CircuitMonkey/6530-CHIPz-reDIP-RIOT/hardware/documentation/ice_to_signal_map.ods

CHP Name | Pin Num | ICE Num
Vss | 1
PA0 | 2 | ICE32
Phi 2 | 3 | ICE31
RSO | 4 | ICE28
A9 | 5 | ICE39_OD
A8 | 6 | ICE40_OD
A7 | 7 | ICE41_OD
A6 | 8 | ICE25
RW | 9 | ICE26
A5 | 10 | ICE27
A4 | 11 | ICE23
A3 | 12 | ICE21
A2 | 13 | ICE20
A1 | 14 | SPI_SIO3
A0 | 15 | SPI_SIO2
RST | 16 | SPI_SIO1
IRQ/PB7 | 17 | SPI_SCLK
CS1/PB6 | 18 | SPI_SIO0
CS2/PB5 | 19 | ICE13
Vcc | 20
PB4 | 21 | ICE12
PB3 | 22 | ICE11
PB2 | 23 | ICE10
PB1 | 24 | ICE9
PB0 | 25 | ICE47
D7 | 26 | ICE48
D6 | 27 | ICE2
D5 | 28 | ICE3
D4 | 29 | ICE4
D3 | 30 | ICE6
D2 | 31 | ICE46
D1 | 32 | ICE45
D0 | 33 | ICE44
PA7 | 34 | ICE43
PA6 | 35 | ICE42
PA5 | 36 | ICE38
PA4 | 37 | ICE37
PA3 | 38 | ICE36
PA2 | 39 | ICE35
PA1 | 40 | ICE34
