CircuitMonkey/6530-CHIPz-reDIP-RIOT/hardware/documentation/CHIPz-RIOT-bom.ods

CHIPz 6530 RIOT Module for KIM-1000 |  |  | Rev. A
Reference | Qty | Value | Footprint | Datasheet
C1,C3,C11 | 3 | 4.7uF | Capacitor_SMD:C_0402_1005Metric_Pad0.74x0.62mm_HandSolder | ~
C2,C4,C5,C6,C7,C8,C9,C10 | 8 | 0.1uF | Capacitor_SMD:C_0402_1005Metric_Pad0.74x0.62mm_HandSolder | ~
J1 | 1 | Conn_01x10 | Connector_JST:JST_SHL_SM10B-SHLS-TF_1x10-1MP_P1.00mm_Horizontal | ~
Q1 | 1 | BC847W | Package_TO_SOT_SMD:SOT-323_SC-70 | http://www.infineon.com/dgdl/Infineon-BC847SERIES_BC848SERIES_BC849SERIES_BC850SERIES-DS-v01_01-en.pdf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
Q2 | 1 | FDN340P | Package_TO_SOT_SMD:SOT-23 | https://www.onsemi.com/pub/Collateral/FDN340P-D.PDF
R1 | 1 | 100 | Resistor_SMD:R_0402_1005Metric_Pad0.72x0.64mm_HandSolder | ~
R2,R4 | 2 | 10K | Resistor_SMD:R_0402_1005Metric_Pad0.72x0.64mm_HandSolder | ~
R3 | 1 | 2.87K | Resistor_SMD:R_0402_1005Metric_Pad0.72x0.64mm_HandSolder | ~
R5 | 1 | 1K | Resistor_SMD:R_0402_1005Metric_Pad0.72x0.64mm_HandSolder | ~
R6 | 1 | 20K | Resistor_SMD:R_0402_1005Metric_Pad0.72x0.64mm_HandSolder | ~
R7 | 1 | 100K | Resistor_SMD:R_0402_1005Metric_Pad0.72x0.64mm_HandSolder | ~
U1 | 1 | NCP115AMX120TCG | onsemi:CASE_711AJ_1.0x1.0mm_P0.65mm | https://www.onsemi.com/pdf/datasheet/ncp115-d.pdf
U2 | 1 | ICE40UP5K-SG48ITR | Package_DFN_QFN:QFN-48-1EP_7x7mm_P0.5mm_EP5.6x5.6mm | http://www.latticesemi.com/Products/FPGAandCPLD/iCE40Ultra
U3 | 1 | AT25SF081BMAH*T | CM_Chip_Packages:UDFN-8_EP_3x2_Pitch0.5mm | https://www.adestotech.com/wp-content/uploads/DS-AT25SF081_045.pdf
