CircuitMonkey/6530-CHIPz-reDIP-RIOT/hardware/documentation/CHIPz-RIOT-sch.pdf

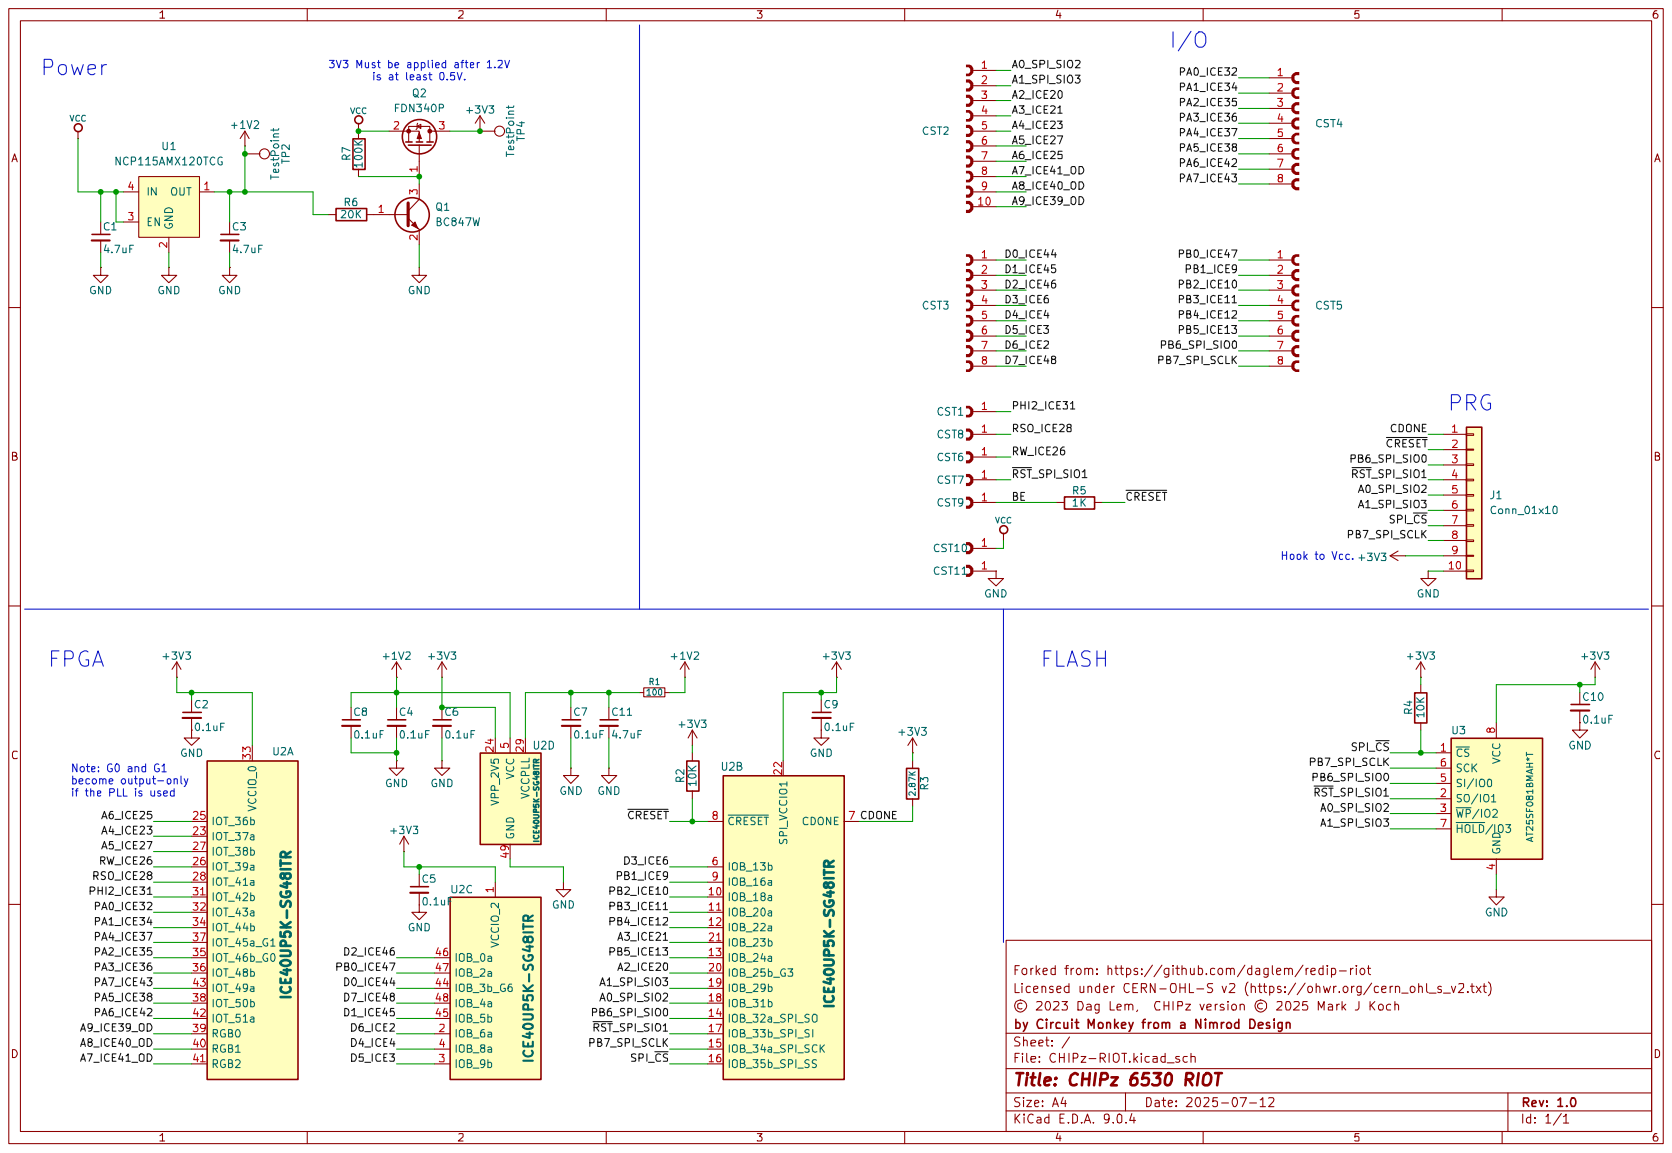
[picture p1: page 1]
