CircuitMonkey/6530-CHIPz-reDIP-RIOT/hardware/CHIPz-RIOT.kicad_pcb

## KiCad design hardware/CHIPz-RIOT.kicad_pcb (2025-07-17)

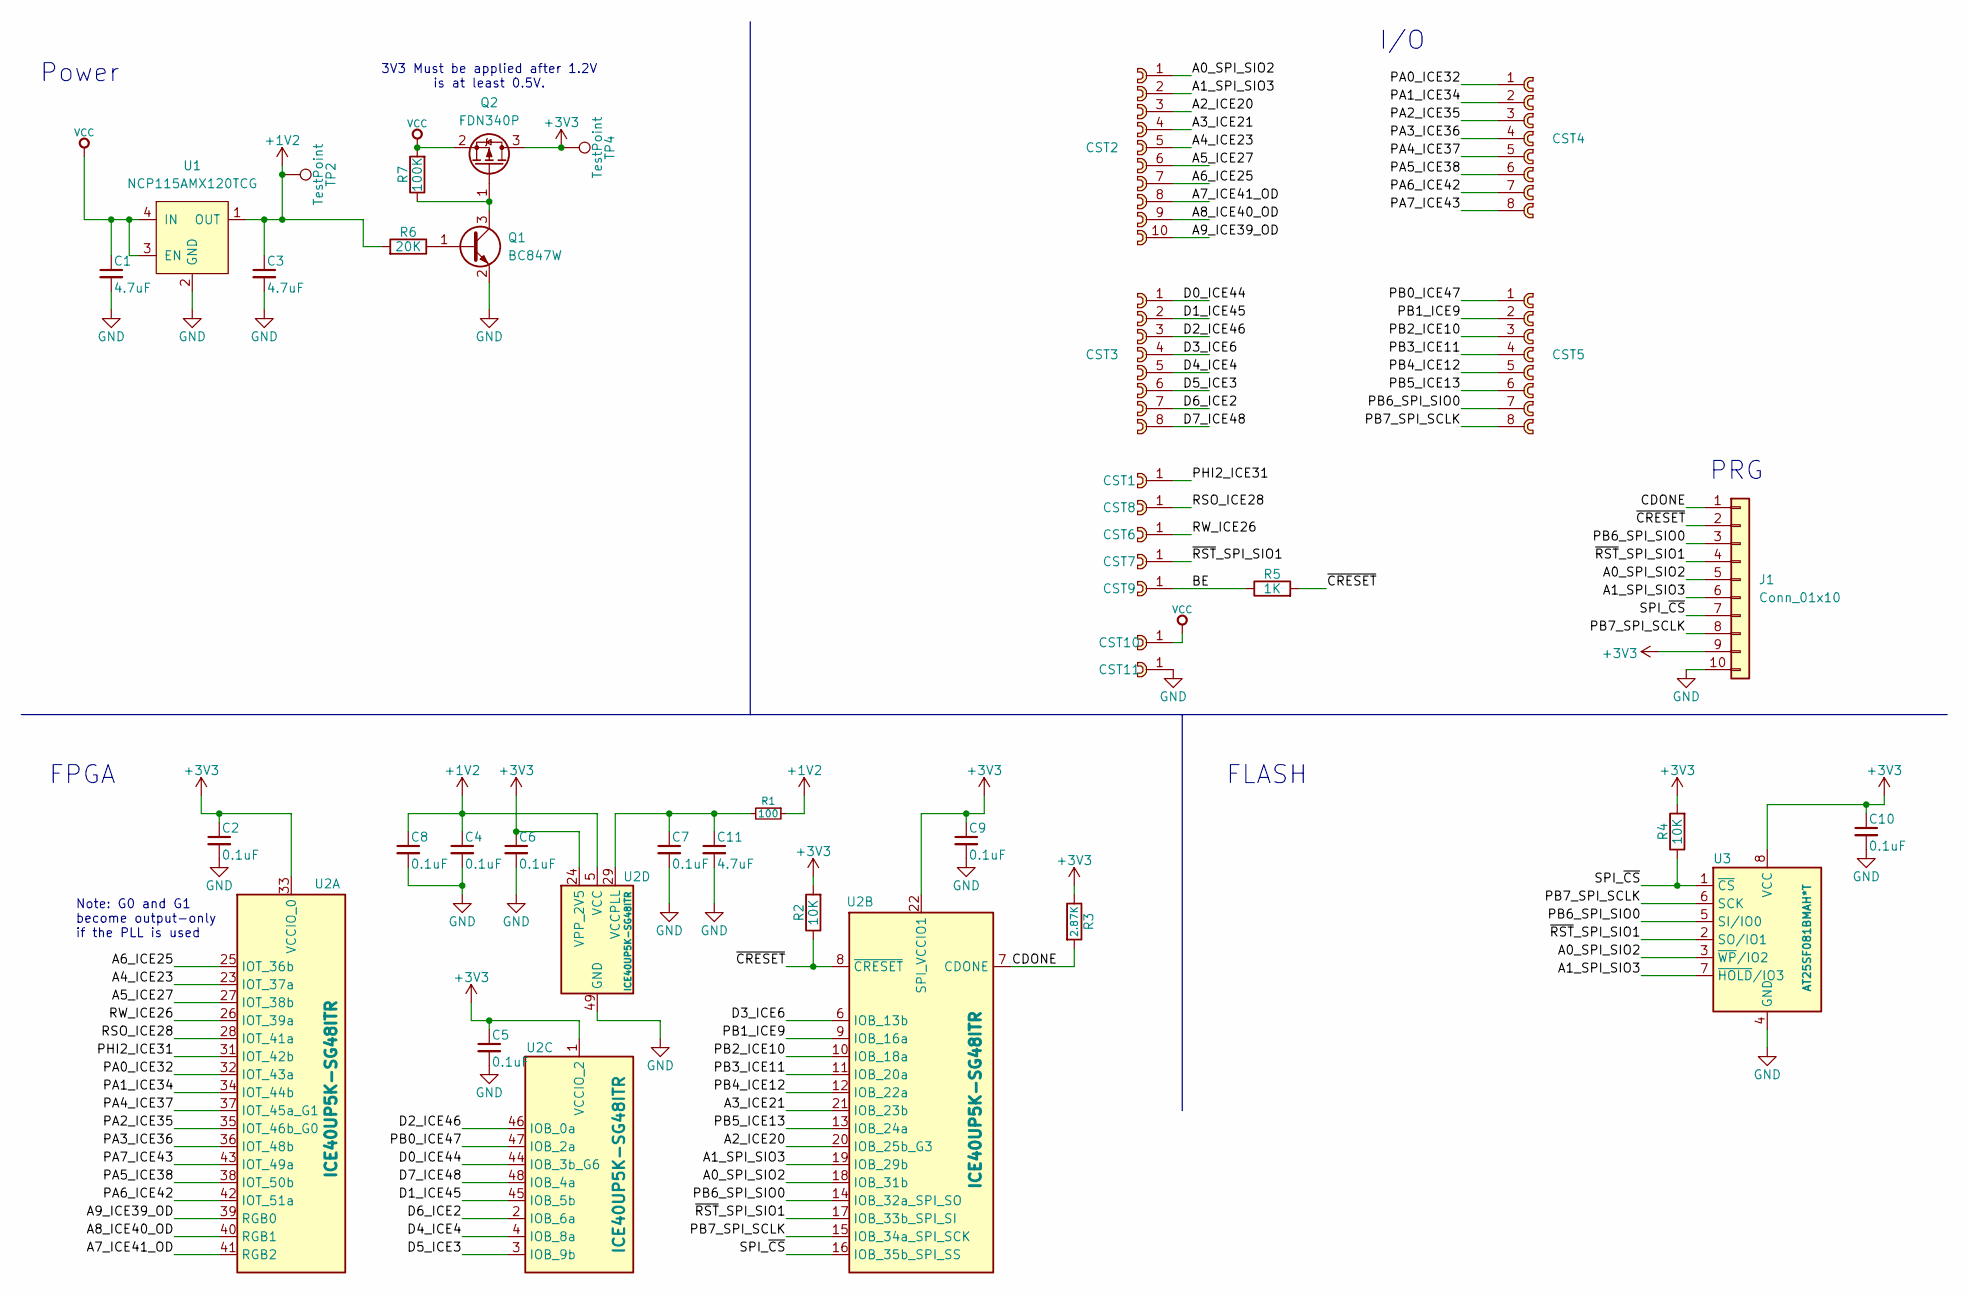
[picture p2: schematic CHIPz-RIOT.kicad_sch, CHIPz 6530 RIOT]

Parts:
C1, C3, C11: 4.7uF; C_0402_1005Metric_Pad0.74x0.62mm_HandSolder
C2, C4, C5, C6, C7, C8, C9, C10: 0.1uF; C_0402_1005Metric_Pad0.74x0.62mm_HandSolder
CST1, CST6, CST7, CST8, CST9, CST10, CST11: cast-2.0-01P
CST2: cast-2.0-10P
CST3, CST4, CST5: cast-2.0-08P
J1: Conn_01x10; JST_SHL_SM10B-SHLS-TF_1x10-1MP_P1.00mm_Horizontal
Q1: BC847W; SOT-323_SC-70
Q2: FDN340P; SOT-23
R1: 100; R_0402_1005Metric_Pad0.72x0.64mm_HandSolder
R2, R4: 10K; R_0402_1005Metric_Pad0.72x0.64mm_HandSolder
R3: 2.87K; R_0402_1005Metric_Pad0.72x0.64mm_HandSolder
R5: 1K; R_0402_1005Metric_Pad0.72x0.64mm_HandSolder
R6: 20K; R_0402_1005Metric_Pad0.72x0.64mm_HandSolder
R7: 100K; R_0402_1005Metric_Pad0.72x0.64mm_HandSolder
TP2, TP4: TestPoint; TestPoint_Pad_D1.00mm
U1: NCP115AMX120TCG; CASE_711AJ_1.0x1.0mm_P0.65mm
U2: ICE40UP5K-SG48ITR; QFN-48-1EP_7x7mm_P0.5mm_EP5.6x5.6mm
U3: AT25SF081BMAH*T; UDFN-8_EP_3x2_Pitch0.5mm

Connections:
+1V2: C3.1, C4.1, C8.1, R1.1, R6.2, TP2.1, U1.1 (OUT), U2.5 (VCC), U2.30 (VCC)
+3V3: C2.1, C5.1, C6.1, C9.1, C10.1, J1.9, Q2.3 (D), R2.2, R3.1, R4.2, TP4.1, U2.1 (VCCIO_2), U2.22 (SPI_VCCIO1), U2.24 (VPP_2V5), U2.33 (VCCIO_0), U3.8 (VCC)
/A0_SPI_SIO2: CST2.1, J1.5, U2.18 (IOB_31b), U3.3 (~WP/IO2)
/A1_SPI_SIO3: CST2.2, J1.6, U2.19 (IOB_29b), U3.7 (~HOLD/IO3)
/A2_ICE20: CST2.3, U2.20 (IOB_25b_G3)
/A3_ICE21: CST2.4, U2.21 (IOB_23b)
/A4_ICE23: CST2.5, U2.23 (IOT_37a)
/A5_ICE27: CST2.6, U2.27 (IOT_38b)
/A6_ICE25: CST2.7, U2.25 (IOT_36b)
/A7_ICE41_OD: CST2.8, U2.41 (RGB2)
/A8_ICE40_OD: CST2.9, U2.40 (RGB1)
/A9_ICE39_OD: CST2.10, U2.39 (RGB0)
/BE: CST9.1, R5.1
/CDONE: J1.1, R3.2, U2.7 (CDONE)
/D0_ICE44: CST3.1, U2.44 (IOB_3b_G6)
/D1_ICE45: CST3.2, U2.45 (IOB_5b)
/D2_ICE46: CST3.3, U2.46 (IOB_0a)
/D3_ICE6: CST3.4, U2.6 (IOB_13b)
/D4_ICE4: CST3.5, U2.4 (IOB_8a)
/D5_ICE3: CST3.6, U2.3 (IOB_9b)
/D6_ICE2: CST3.7, U2.2 (IOB_6a)
/D7_ICE48: CST3.8, U2.48 (IOB_4a)
/PA0_ICE32: CST4.1, U2.32 (IOT_43a)
/PA1_ICE34: CST4.2, U2.34 (IOT_44b)
/PA2_ICE35: CST4.3, U2.35 (IOT_46b_G0)
/PA3_ICE36: CST4.4, U2.36 (IOT_48b)
/PA4_ICE37: CST4.5, U2.37 (IOT_45a_G1)
/PA5_ICE38: CST4.6, U2.38 (IOT_50b)
/PA6_ICE42: CST4.7, U2.42 (IOT_51a)
/PA7_ICE43: CST4.8, U2.43 (IOT_49a)
/PB0_ICE47: CST5.1, U2.47 (IOB_2a)
/PB1_ICE9: CST5.2, U2.9 (IOB_16a)
/PB2_ICE10: CST5.3, U2.10 (IOB_18a)
/PB3_ICE11: CST5.4, U2.11 (IOB_20a)
/PB4_ICE12: CST5.5, U2.12 (IOB_22a)
/PB5_ICE13: CST5.6, U2.13 (IOB_24a)
/PB6_SPI_SIO0: CST5.7, J1.3, U2.14 (IOB_32a_SPI_SO), U3.5 (SI/IO0)
/PB7_SPI_SCLK: CST5.8, J1.8, U2.15 (IOB_34a_SPI_SCK), U3.6 (SCK)
/PHI2_ICE31: CST1.1, U2.31 (IOT_42b)
/RSO_ICE28: CST8.1, U2.28 (IOT_41a)
/RW_ICE26: CST6.1, U2.26 (IOT_39a)
/SPI_~CS: J1.7, R4.1, U2.16 (IOB_35b_SPI_SS), U3.1 (~CS)
/~CRESET: J1.2, R2.1, R5.2, U2.8 (~CRESET)
/~RST_SPI_SIO1: CST7.1, J1.4, U2.17 (IOB_33b_SPI_SI), U3.2 (SO/IO1)
GND: C1.2, C2.2, C3.2, C4.2, C5.2, C6.2, C7.2, C8.2, C9.2, C10.2, C11.2, CST11.1, J1.10, Q1.2 (E), U1.2 (GND), U2.49 (GND), U3.4 (GND)
unnamed: Q1.1 (B), R6.1
unnamed: Q1.3 (C), Q2.1 (G), R7.1
unnamed: C7.1, C11.1, R1.2, U2.29 (VCCPLL)
VCC: C1.1, CST10.1, Q2.2 (S), R7.2, U1.3 (EN), U1.4 (IN)

Notes on the sheet:
PRG
FLASH
FPGA
Power
3V3 Must be applied after 1.2V is at least 0.5V.
I/O
Note: G0 and G1 become output-only if the PLL is used

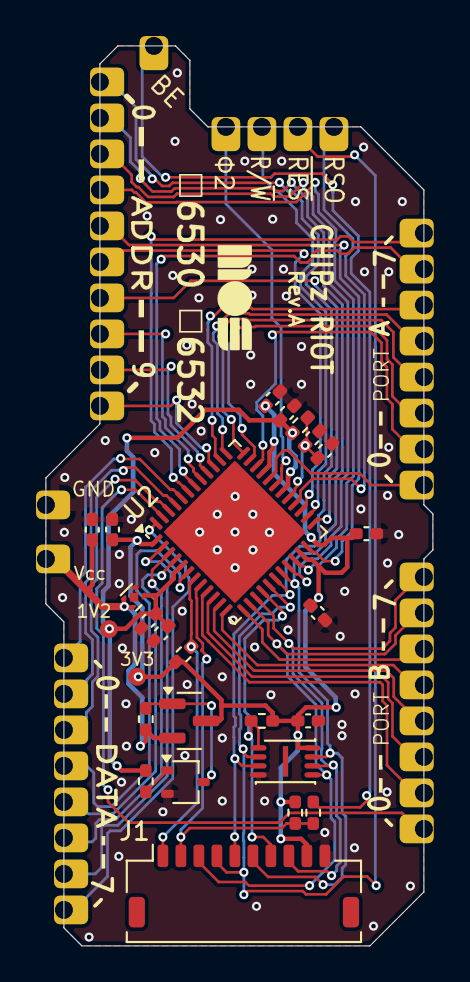
[picture p3: board CHIPz-RIOT.kicad_pcb from above]

Board: 2 copper layers, 21.5 x 50.0 mm, 37 parts (0 on the bottom side), 49 nets.
