CircuitMonkey/6530-CHIPz-reDIP-RIOT/(commit log)

2025-07-17 New version of reDIP-RIOT PCB, now CHIPz RIOT.
    [CHIPz-RIOT.kicad_pcb, CHIPz-RIOT.kicad_sch, ice_to_signal_map.ods, reDIP-RIOT.kicad_pcb, reDIP-RIOT.kicad_sch]
2025-07-17 Add 3D models for Chips and connector
    [CHIPz-RIOT.kicad_pcb]
2025-09-07 Added assembly note/change.
    [CHIPz-RIOT.kicad_sch]
