CircuitMonkey/6530-CHIPz-reDIP-RIOT/(notices)

Notices in the files:
hardware/CHIPz-RIOT.kicad_sch:
© 2023 Dag Lem, CHIPz version © 2025 Mark J Koch
Licensed under CERN-OHL-S v2 (https://ohwr.org/cern_ohl_s_v2.txt)
hardware/CHIPz-RIOT.kicad_pcb:
© 2023 Dag Lem
CERN-OHL-S v2
